NiciKreis/ET21-Frackstock/DOC_Frackstock/IMU.md

### IMU

Als IMU wurde bisher der BMI160 von Bosch verwendet. Dieser wurde abgekündigt, ein möglicher Ersatz ist der BMI323. Hardwaremässig kann der chip ersetzt werden, fraglich ist, ob die Arduino-Library mitspielt.

###
