NiciKreis/ET21-Frackstock/DOC_Frackstock/MCU.md

### Crystal

Der Clock wird mit zwei 14pF Kondensatoren gestützt. Gemäss Datenblatt RP2040 wäre dies jedoch nicht nötig. Falls der Quartz nicht schwingen sollte, müssten diese entfernt werden.

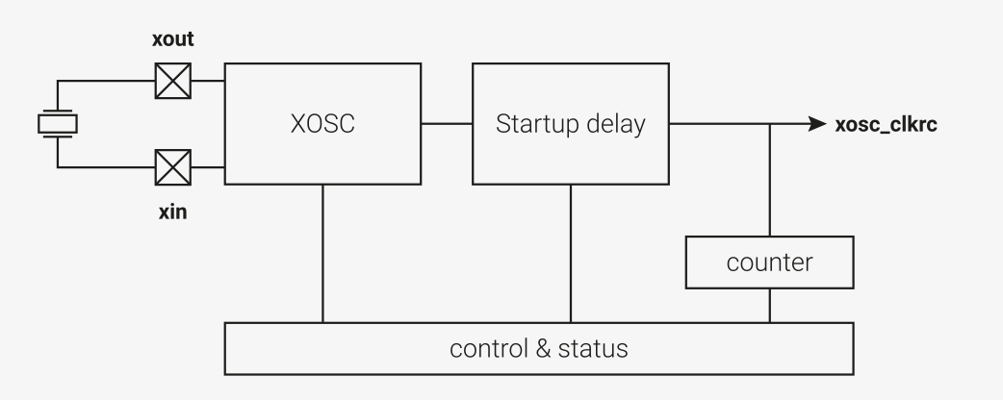
[picture p4: DOC_Frackstock/Assets/image-20240214121256330.png]
######
