NiciKreis/ET21-Frackstock/DOC_Frackstock/Assets/image-20231116143248241.png

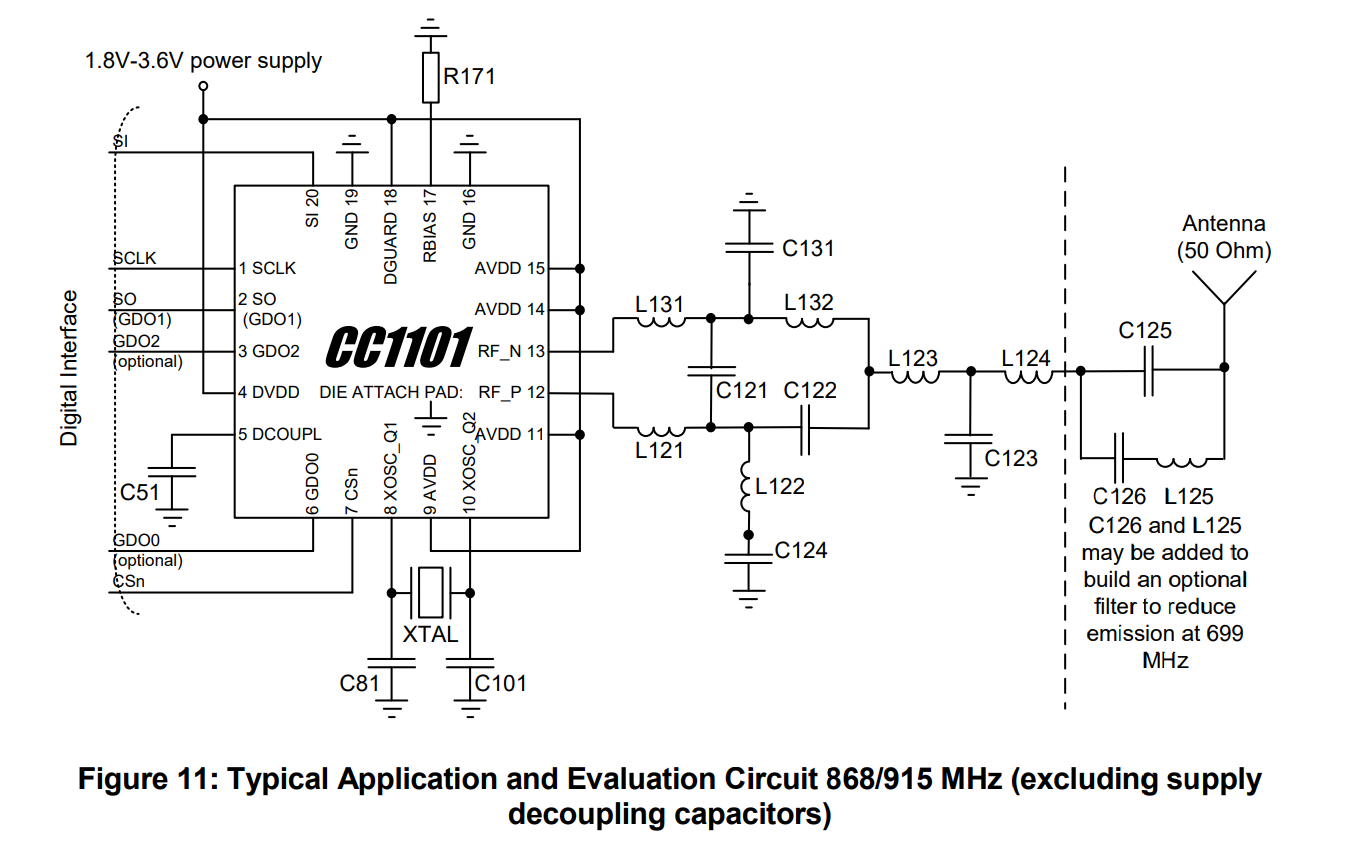
DOC_Frackstock/Assets/image-20231116143248241.png
