NiciKreis/ET21-Frackstock/DOC_Frackstock/Assets/image-20231116144048629.png

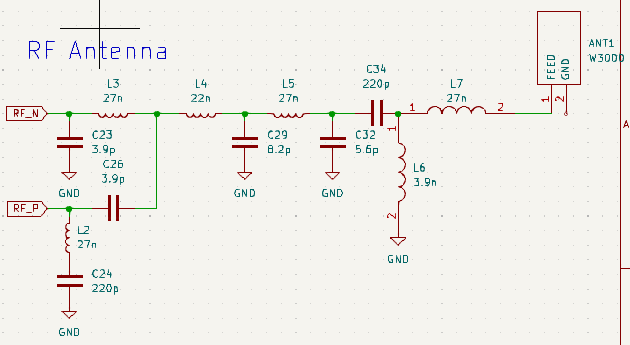
DOC_Frackstock/Assets/image-20231116144048629.png
