NiciKreis/ET21-Frackstock/IMG_20230823_181511.jpg

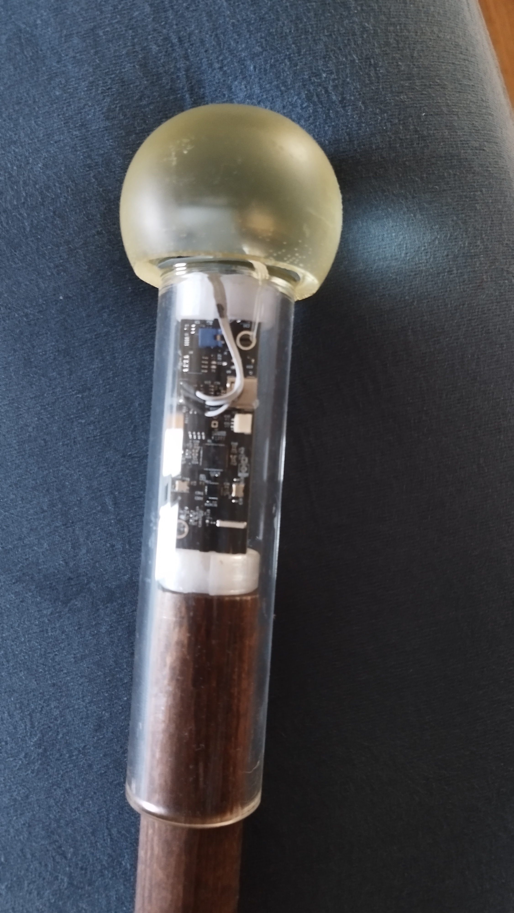
IMG_20230823_181511.jpg
