NiciKreis/ET21-Frackstock/IMG_20230823_181516.jpg

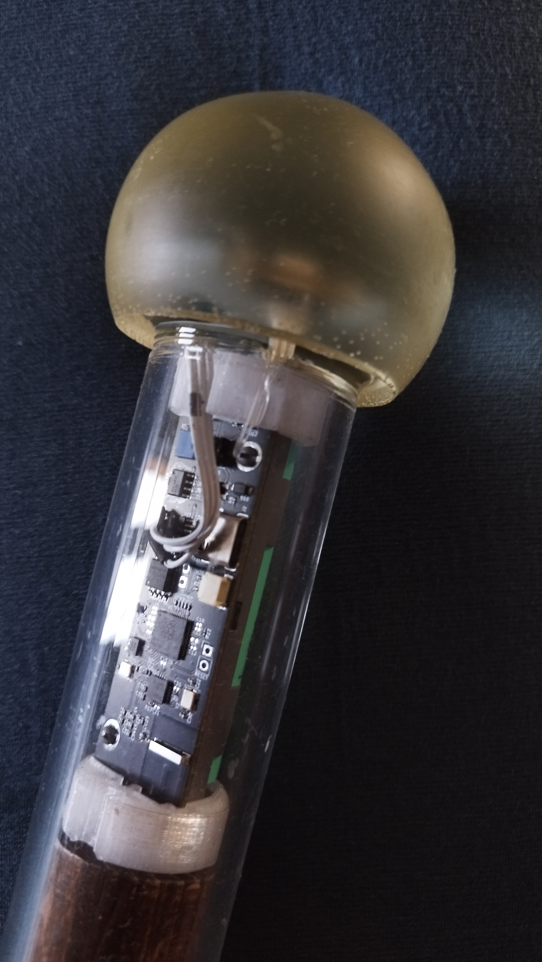
IMG_20230823_181516.jpg
