NiciKreis/ET21-Frackstock/IMG_20230823_181558.jpg

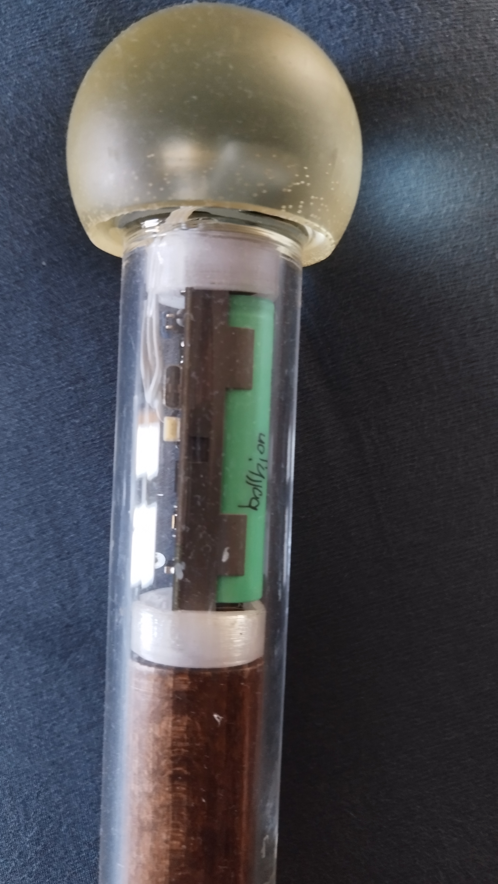
IMG_20230823_181558.jpg
