NiciKreis/ET21-Frackstock/IMG_20230823_181706.jpg

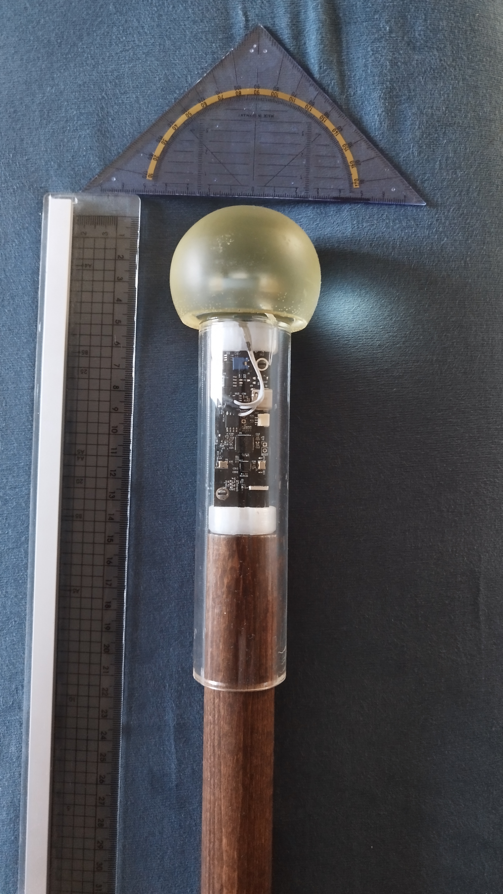
IMG_20230823_181706.jpg
