NiciKreis/ET21-Frackstock/IMG_20230823_181718.jpg

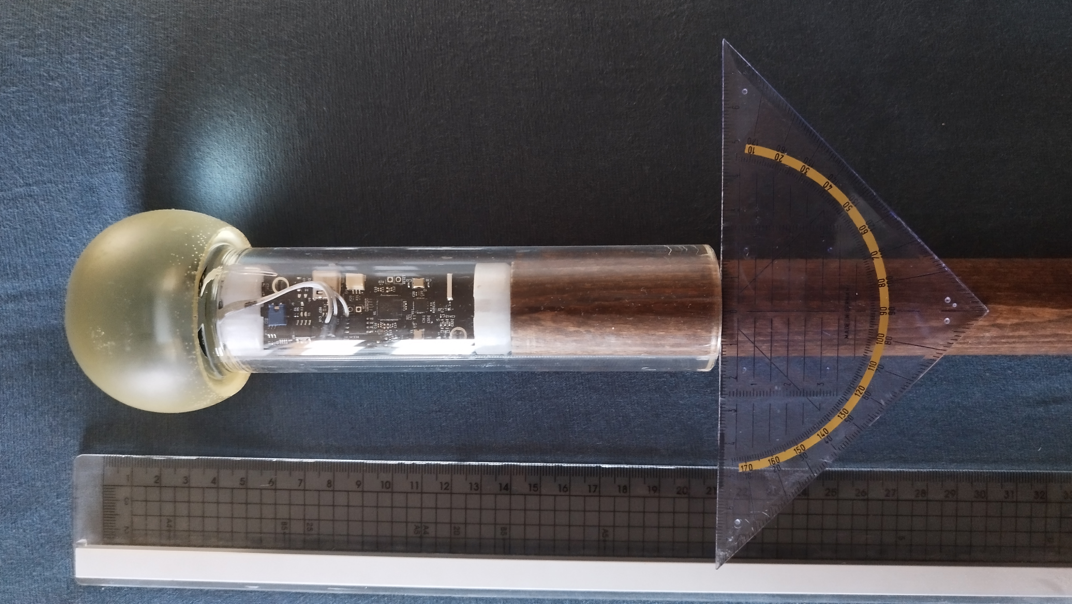
IMG_20230823_181718.jpg
