NiciKreis/ET21-Frackstock/PCB_Frackstock/Frackstock.step

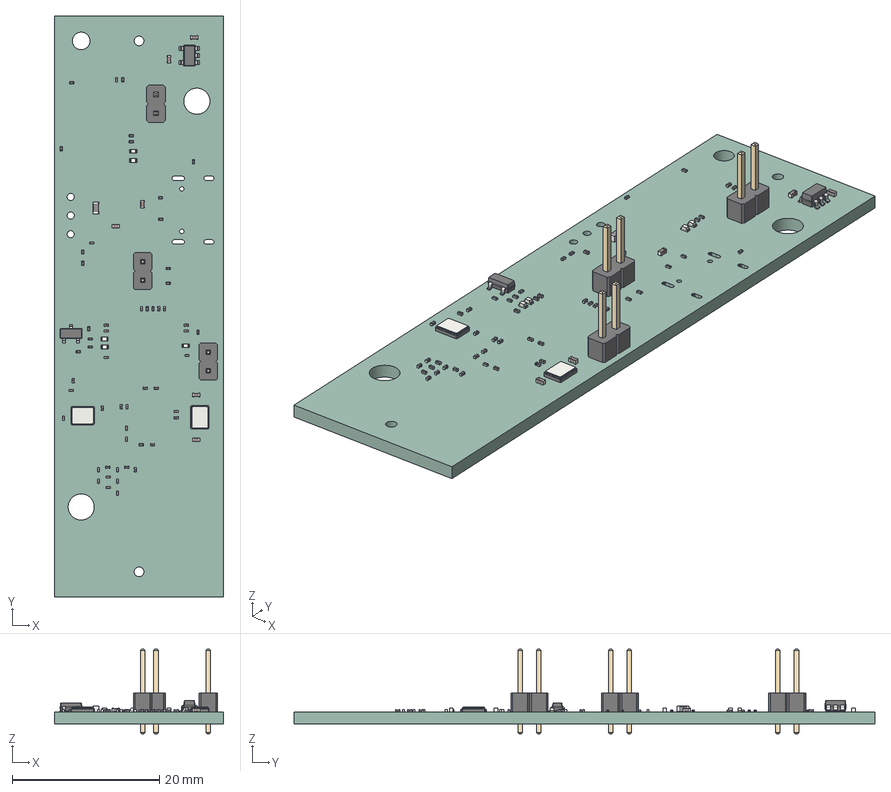
[picture p12: CAD file, 2023-11-22]
PCB_Frackstock/Frackstock.step
23.0 x 79.0 x 11.5 mm
Frackstock PCB
