NiciKreis/ET21-Frackstock/PCB_LedRing/Components/LIB_PCA9552D,118/PCA9552D,118.stp

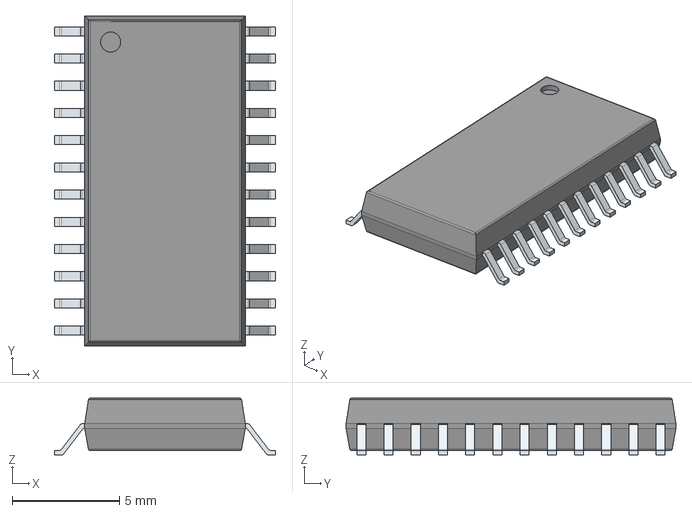
[picture p13: CAD file, 2024-02-25]
PCB_LedRing/Components/LIB_PCA9552D,118/PCA9552D,118.stp
10.3 x 15.4 x 2.65 mm
PinsArrayLR
