NiciKreis/ET21-Frackstock/PCB_LedRing/PCB_LedRing.step

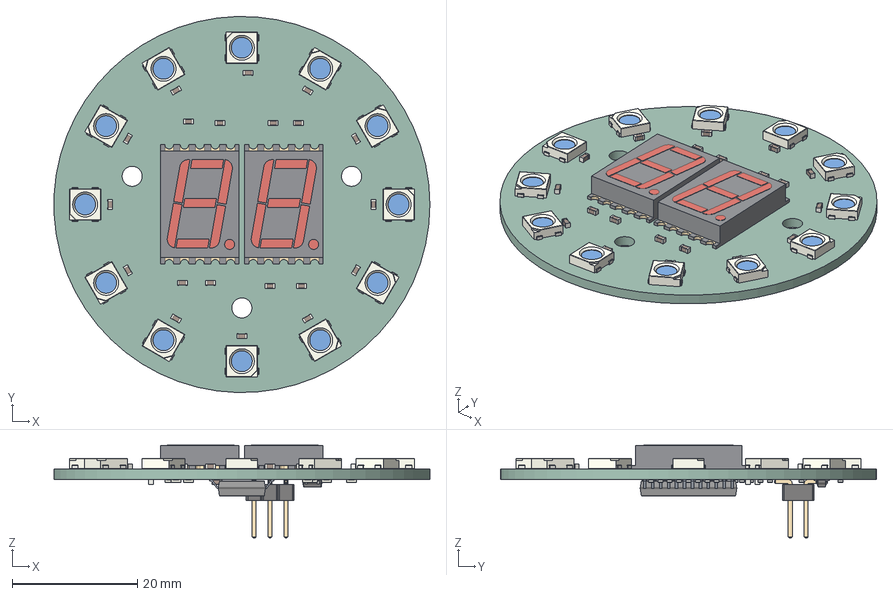
[picture p14: CAD file, 2024-04-09]
PCB_LedRing/PCB_LedRing.step
60.0 x 60.0 x 14.8 mm
LED_SK6812_PLCC4_50x50mm_P32mm x 12
C_0603_1608Metric x 23
7SEGMENT-LED__HDSM531_HDSM533_SMD x 2
SOT_23
R_0603_1608Metric x 27
ASSEMBLY
PinHeader_2x03_P254mm_Vertical_SMD
_autosave-PCB_LedRing PCB
