NiciKreis/ET21-Frackstock/PCB_LedRing/export/PCB_LedRing.pdf

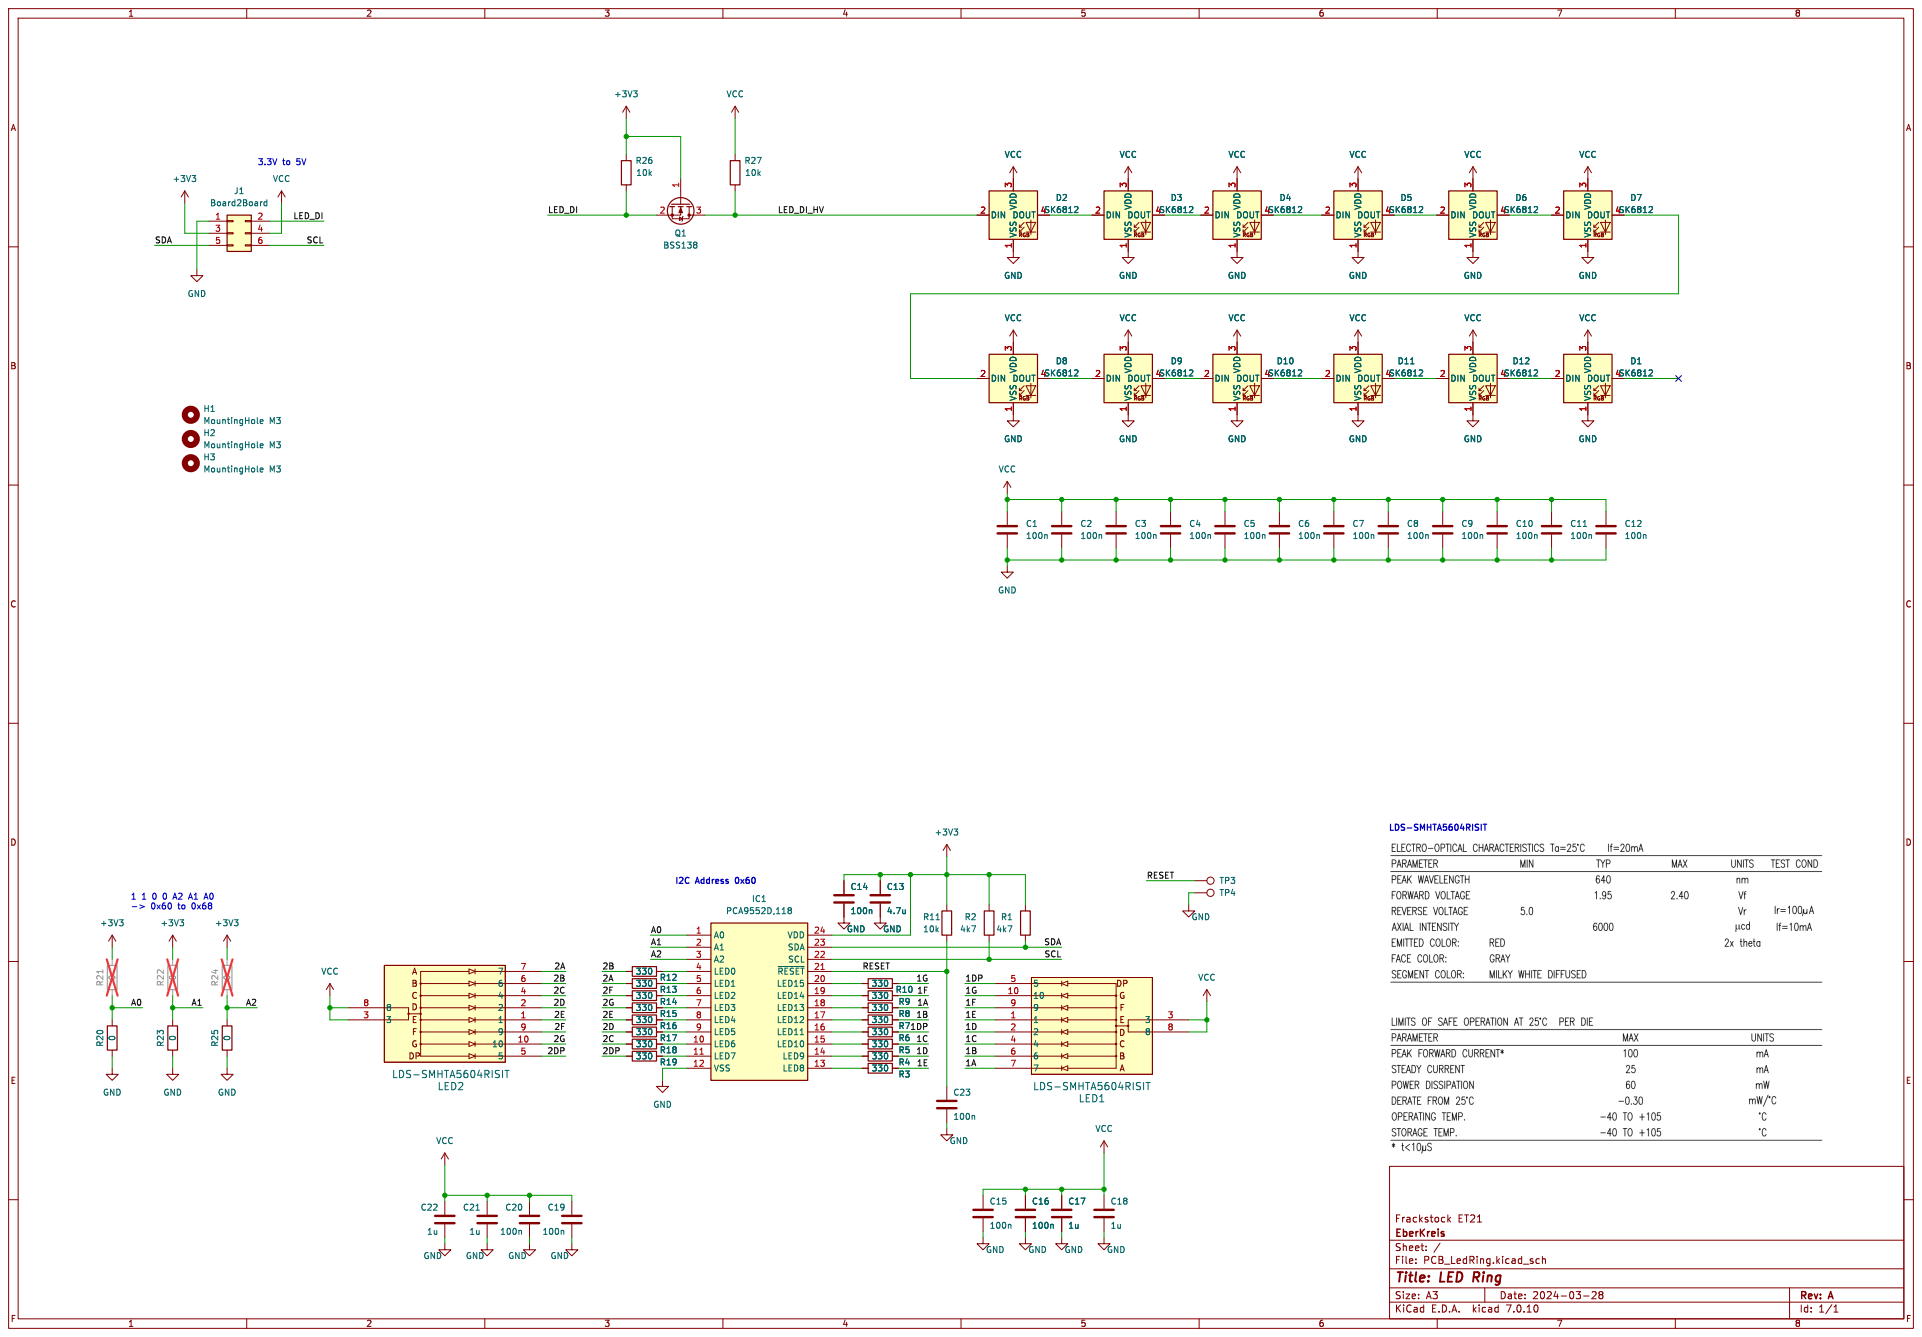
[picture p15: page 1]

3 DOUT 4 D5 SK6812 GND VSS RGB 1 DIN 2 VDD
D4 SK6812 VSS

3 DOUT 4 D10 SK6812 GND VSS RGB 1 DIN 2 VDD

3 DOUT 4 D11 SK6812 VSS RGB 1 DIN 2 VDD
D10 SK6812 VSS

LED15 20 ~{RESET}21 SCL 22 SDA 23 VDD 24 A2 3

Id: 1/1 Title: LED Ring
