NiciKreis/ET21-Frackstock/PCB_LedRing/PCB_LedRing.kicad_pcb

## KiCad design PCB_LedRing/PCB_LedRing.kicad_pcb (2024-04-05)

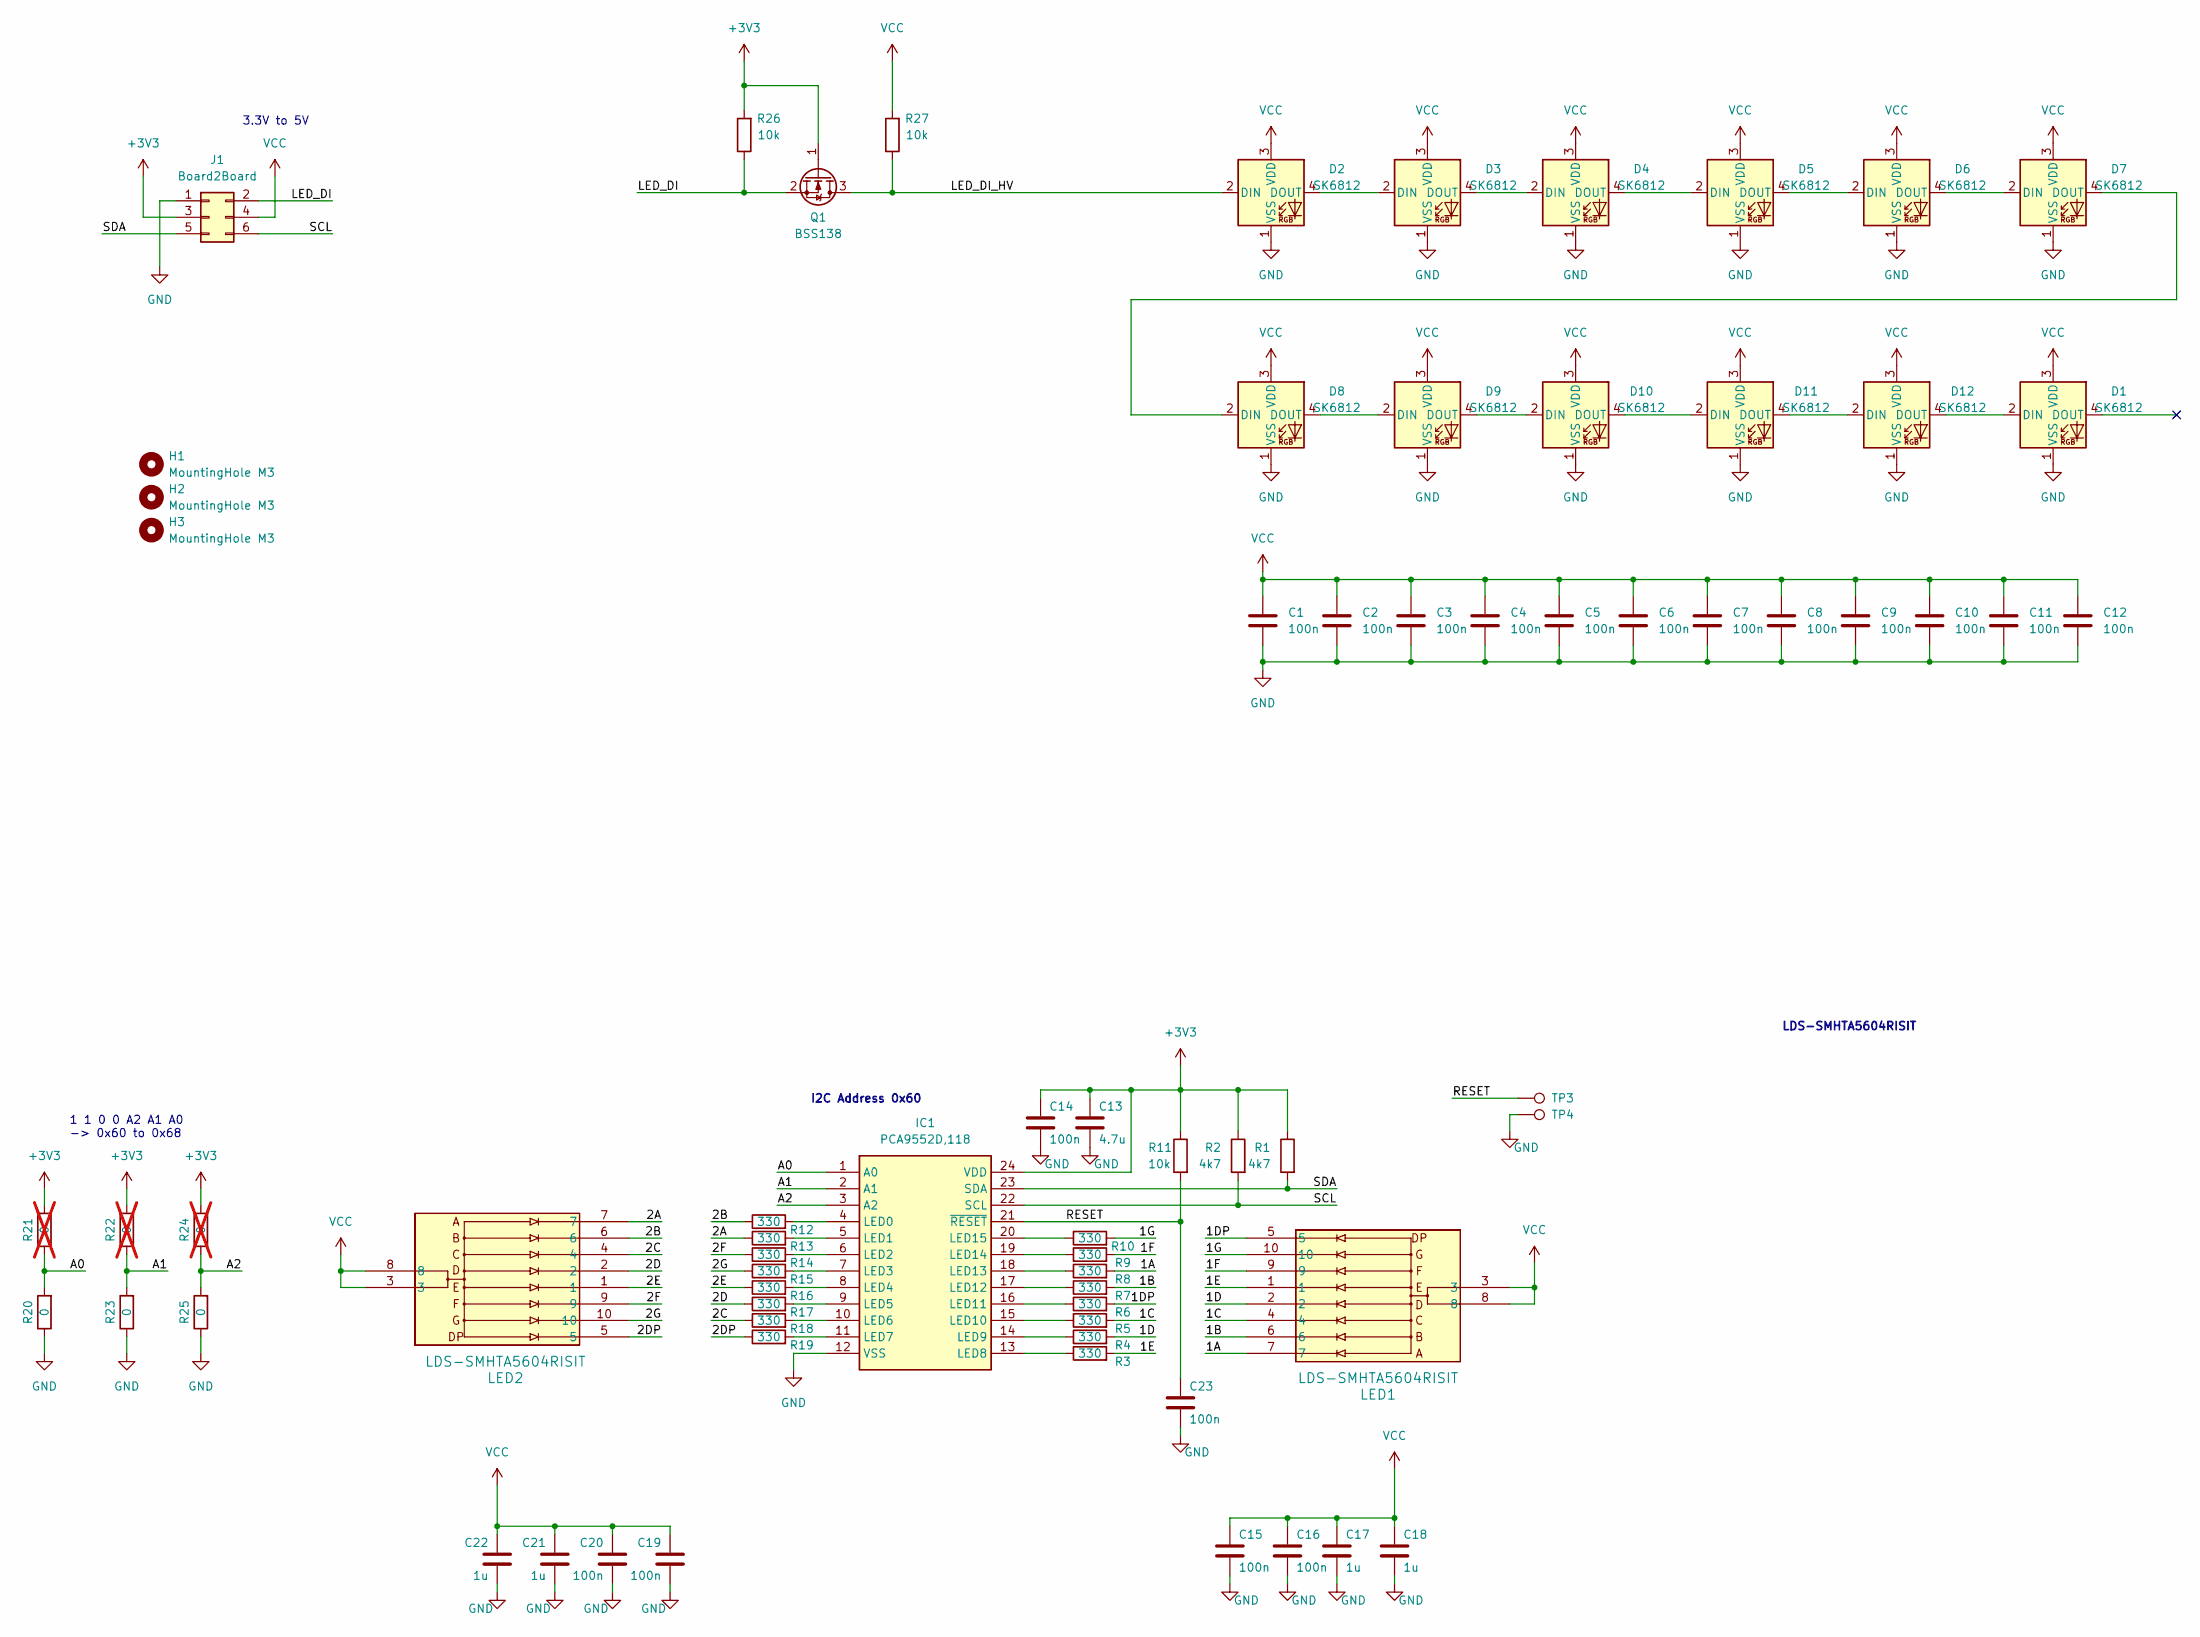
[picture p16: schematic PCB_LedRing.kicad_sch, LED Ring]

Parts:
C1, C2, C3, C4, C5, C6, C7, C8, C9, C10, C11, C12, C14, C15, C16, C19, C20, C23: 100n; C_0603_1608Metric_Pad1.08x0.95mm_HandSolder
C13: 4.7u; C_0603_1608Metric_Pad1.08x0.95mm_HandSolder
C17, C18, C21, C22: 1u; C_0603_1608Metric_Pad1.08x0.95mm_HandSolder
D1, D2, D3, D4, D5, D6, D7, D8, D9, D10, D11, D12: SK6812; LED_SK6812_PLCC4_5.0x5.0mm_P3.2mm
H1, H2, H3: MountingHole M3; MountingHole_3.2mm_M3
IC1: PCA9552D,118; SOIC127P1032X265-24N; Mouser Part Number 771-PCA9552D-T
J1: Board2Board; PinHeader_2x03_P2.54mm_Vertical_SMD; Mouser 649-1012938390602BLF
LED1, LED2: LDS-SMHTA5604RISIT; LDS-SMHTA5604RISIT_LUM; Mouser 696-LDSSMHTA5604RISI
Q1: BSS138; SOT-23; Mouser 512-BSS138
R1, R2: 4k7; R_0603_1608Metric_Pad0.98x0.95mm_HandSolder
R3, R4, R5, R6, R7, R8, R9, R10, R12, R13, R14, R15, R16, R17, R18, R19: 330; R_0603_1608Metric_Pad0.98x0.95mm_HandSolder
R11, R26, R27: 10k; R_0603_1608Metric_Pad0.98x0.95mm_HandSolder
R20, R23, R25: 0; R_0603_1608Metric_Pad0.98x0.95mm_HandSolder
R21, R22, R24: 0; R_0603_1608Metric_Pad0.98x0.95mm_HandSolder; not fitted
TP3, TP4: TestPoint; TestPoint_Pad_D3.0mm

Connections:
+3V3: C13.1, C14.1, IC1.24 (VDD), J1.3, Q1.1 (G), R1.1, R2.1, R11.1, R21.2, R22.2, R24.2, R26.2
/1A: LED1.7, R8.2
/1B: LED1.6, R7.2
/1C: LED1.4, R5.2
/1D: LED1.2, R4.2
/1DP: LED1.5, R6.2
/1E: LED1.1, R3.2
/1F: LED1.9, R9.2
/1G: LED1.10, R10.2
/2A: LED2.7, R13.1
/2B: LED2.6, R12.1
/2C: LED2.4, R18.1
/2D: LED2.2, R17.1
/2DP: LED2.5, R19.1
/2E: LED2.1, R16.1
/2F: LED2.9, R14.1
/2G: LED2.10, R15.1
/A0: IC1.1 (A0), R20.2, R21.1
/A1: IC1.2 (A1), R22.1, R23.2
/A2: IC1.3 (A2), R24.1, R25.2
/LED_DI: J1.2, Q1.2 (S), R26.1
/LED_DI_HV: D2.2 (DIN), Q1.3 (D), R27.1
/RESET: C23.1, IC1.21 (~RESET), R11.2, TP3.1
/SCL: IC1.22 (SCL), J1.6, R2.2
/SDA: IC1.23 (SDA), J1.5, R1.2
GND: C1.2, C2.2, C3.2, C4.2, C5.2, C6.2, C7.2, C8.2, C9.2, C10.2, C11.2, C12.2, C13.2, C14.2, C15.2, C16.2, C17.2, C18.2, C19.2, C20.2, C21.2, C22.2, C23.2, D1.1 (VSS), D2.1 (VSS), D3.1 (VSS), D4.1 (VSS), D5.1 (VSS), D6.1 (VSS), D7.1 (VSS), D8.1 (VSS), D9.1 (VSS), D10.1 (VSS), D11.1 (VSS), D12.1 (VSS), IC1.12 (VSS), J1.1, R20.1, R23.1, R25.1, TP4.1
unnamed: D1.2 (DIN), D12.4 (DOUT)
unnamed: D2.4 (DOUT), D3.2 (DIN)
unnamed: D3.4 (DOUT), D4.2 (DIN)
unnamed: D4.4 (DOUT), D5.2 (DIN)
unnamed: D5.4 (DOUT), D6.2 (DIN)
unnamed: D6.4 (DOUT), D7.2 (DIN)
unnamed: D7.4 (DOUT), D8.2 (DIN)
unnamed: D8.4 (DOUT), D9.2 (DIN)
unnamed: D9.4 (DOUT), D10.2 (DIN)
unnamed: D10.4 (DOUT), D11.2 (DIN)
unnamed: D11.4 (DOUT), D12.2 (DIN)
unnamed: IC1.4 (LED0), R12.2
unnamed: IC1.5 (LED1), R13.2
unnamed: IC1.6 (LED2), R14.2
unnamed: IC1.7 (LED3), R15.2
unnamed: IC1.8 (LED4), R16.2
unnamed: IC1.9 (LED5), R17.2
unnamed: IC1.10 (LED6), R18.2
unnamed: IC1.11 (LED7), R19.2
unnamed: IC1.13 (LED8), R3.1
unnamed: IC1.14 (LED9), R4.1
unnamed: IC1.15 (LED10), R5.1
unnamed: IC1.16 (LED11), R6.1
unnamed: IC1.17 (LED12), R7.1
unnamed: IC1.18 (LED13), R8.1
unnamed: IC1.19 (LED14), R9.1
unnamed: IC1.20 (LED15), R10.1
VCC: C1.1, C2.1, C3.1, C4.1, C5.1, C6.1, C7.1, C8.1, C9.1, C10.1, C11.1, C12.1, C15.1, C16.1, C17.1, C18.1, C19.1, C20.1, C21.1, C22.1, D1.3 (VDD), D2.3 (VDD), D3.3 (VDD), D4.3 (VDD), D5.3 (VDD), D6.3 (VDD), D7.3 (VDD), D8.3 (VDD), D9.3 (VDD), D10.3 (VDD), D11.3 (VDD), D12.3 (VDD), J1.4, LED1.3, LED1.8, LED2.3, LED2.8, R27.2

Notes on the sheet:
1 1 0 0 A2 A1 A0 -> 0x60 to 0x68
I2C Address 0x60
3.3V to 5V
LDS-SMHTA5604RISIT

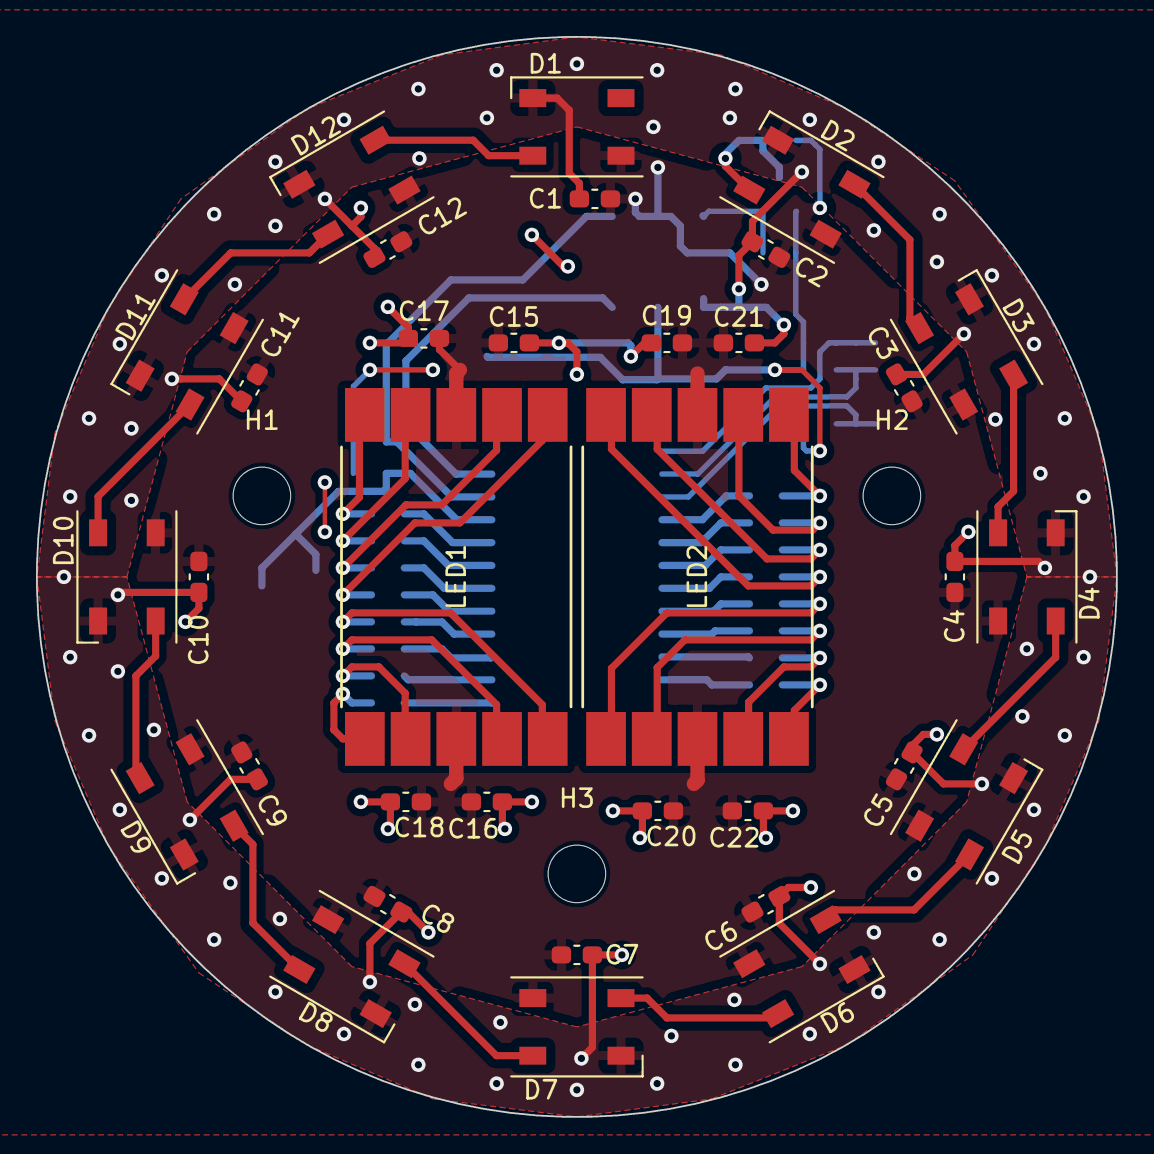
[picture p17: board PCB_LedRing.kicad_pcb from above]

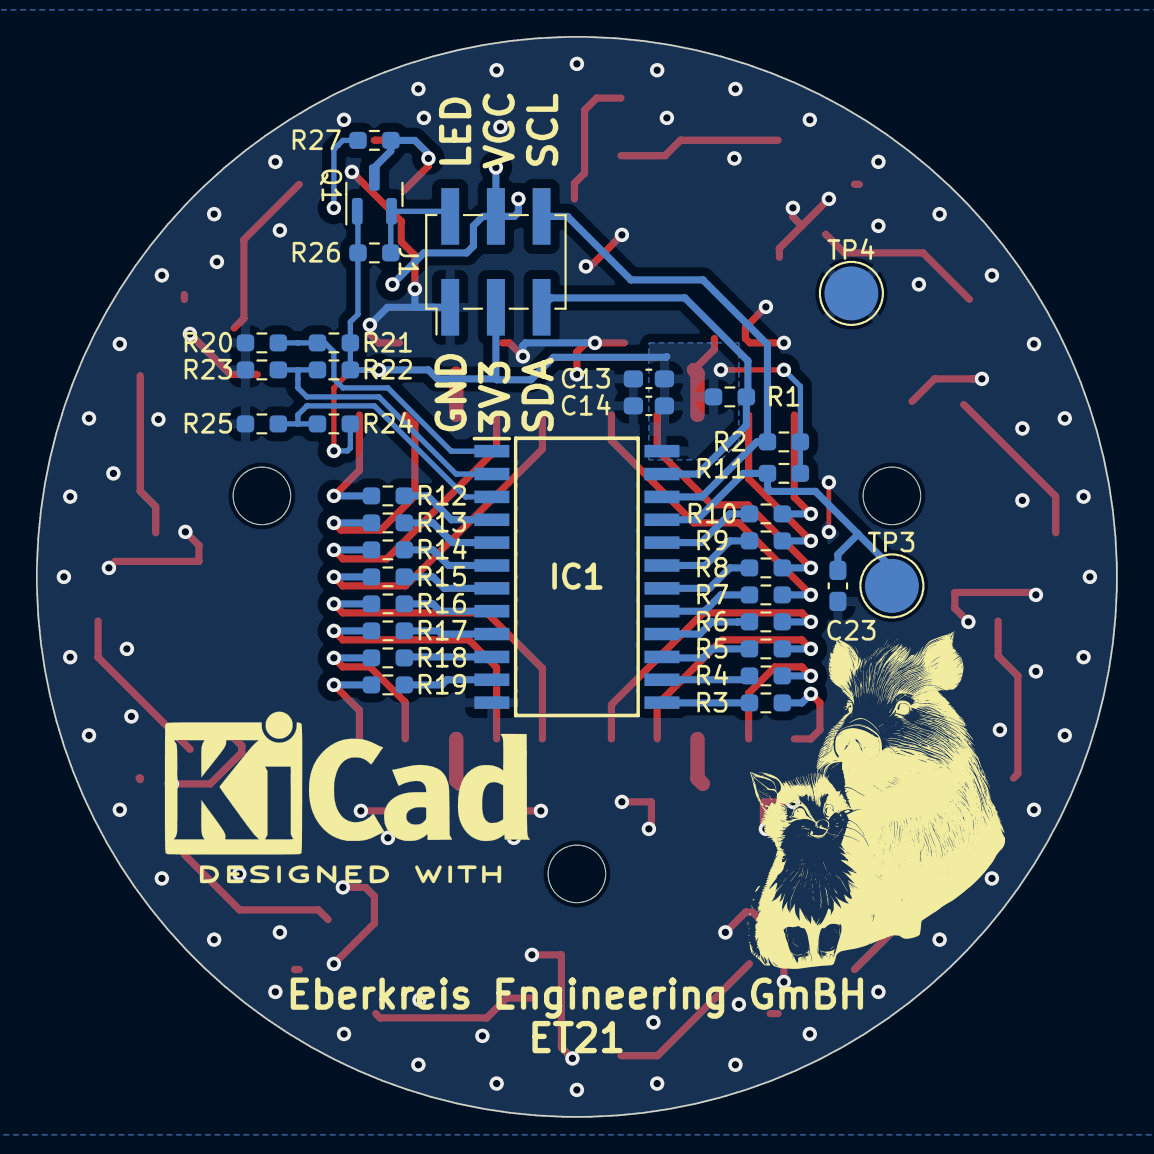
[picture p18: board PCB_LedRing.kicad_pcb from below]

Board: 2 copper layers, 60.0 x 60.0 mm, 72 parts (35 on the bottom side), 54 nets.
