NiciKreis/ET21-Frackstock/PCB_Frackstock/Frackstock.kicad_pcb

## KiCad design PCB_Frackstock/Frackstock.kicad_pcb (2024-03-28)

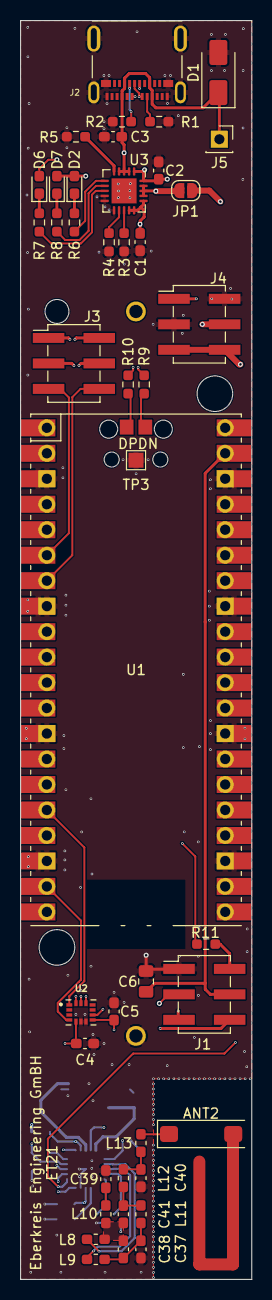
[picture p19: board Frackstock.kicad_pcb from above]

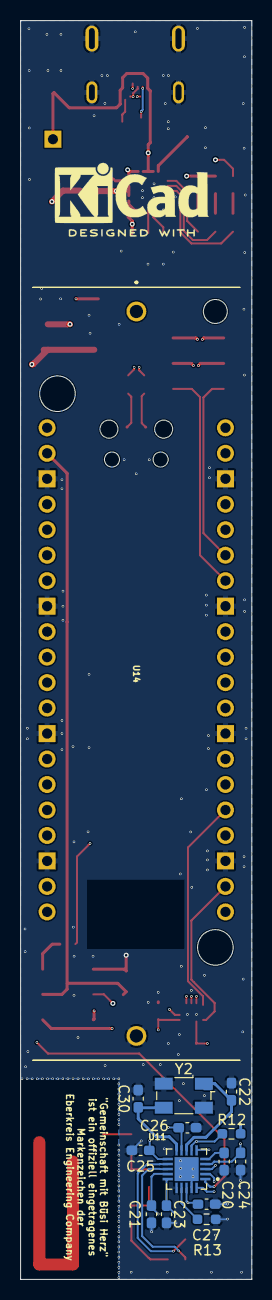
[picture p20: board Frackstock.kicad_pcb from below]

Board: 4 copper layers, 23.0 x 125.5 mm, 59 parts (14 on the bottom side), 56 nets.

Parts:
ANT2: W3000
C1, C2: 4.7u; C_0603_1608Metric_Pad1.08x0.95mm_HandSolder
C3: 10u; C_0603_1608Metric_Pad1.08x0.95mm_HandSolder
C4, C5, C20, C21, C23, C24, C25, C26, C27: 100n; C_0603_1608Metric_Pad1.08x0.95mm_HandSolder
C6: 330u; C_0805_2012Metric_Pad1.18x1.45mm_HandSolder
C22, C30: 20p; C_0603_1608Metric_Pad1.08x0.95mm_HandSolder
C37, C41: 1.5pF; C_0603_1608Metric_Pad1.08x0.95mm_HandSolder
C38: 1p; C_0603_1608Metric_Pad1.08x0.95mm_HandSolder
C39: 100pF; C_0603_1608Metric_Pad1.08x0.95mm_HandSolder
C40: 3.3pF; C_0603_1608Metric_Pad1.08x0.95mm_HandSolder
D1: SMAJ5.0A; D_SMA
D2: Blau; LED_0603_1608Metric_Pad1.05x0.95mm_HandSolder
D6: Rot; LED_0603_1608Metric_Pad1.05x0.95mm_HandSolder
D7: Grün; LED_0603_1608Metric_Pad1.05x0.95mm_HandSolder
J1, J3, J4: Conn_02x03_Pin; PinHeader_2x03_P2.54mm_Vertical_SMD_kleiner
J2: 105450-0101; MOLEX_105450-0101
J5: VBUS; PinSocket_1x01_P2.54mm_Vertical
JP1: SolderJumper_2_Open; SolderJumper-2_P1.3mm_Open_RoundedPad1.0x1.5mm
L8, L9, L12, L13: 12nH; L_0603_1608Metric_Pad1.05x0.95mm_HandSolder
L10, L11: 18nH; L_0603_1608Metric_Pad1.05x0.95mm_HandSolder
R1, R2: 5.1k; R_0603_1608Metric_Pad0.98x0.95mm_HandSolder
R3: 2k; R_0603_1608Metric_Pad0.98x0.95mm_HandSolder
R4: 8.2k; R_0603_1608Metric_Pad0.98x0.95mm_HandSolder
R5, R12: 10k; R_0603_1608Metric_Pad0.98x0.95mm_HandSolder
R6, R8: 390; R_0603_1608Metric_Pad0.98x0.95mm_HandSolder
R7: 430; R_0603_1608Metric_Pad0.98x0.95mm_HandSolder
R9, R10: 27; R_0603_1608Metric_Pad0.98x0.95mm_HandSolder
R11: 470; R_0603_1608Metric_Pad0.98x0.95mm_HandSolder
R13: 56k; R_0603_1608Metric_Pad0.98x0.95mm_HandSolder
TP1, TP2: TestPoint_Alt; TestPoint_Pad_1.5x1.5mm_small
TP3: TestPoint_Alt; TestPoint_Pad_1.5x1.5mm
U1: Pico; RPi_Pico_SMD_ohne_Debug
U2: BMI160; PQFN50P250X300X88-14N
U3: MCP73871-2CC; QFN-20-1EP_4x4mm_P0.5mm_EP2.5x2.5mm
U11: CC1101RGPR; QFN50P400X400X100-21N
U14: 1043; Keystone_1043
Y2: 26MHz; Crystal_SMD_Abracon_ABM3B-4Pin_5.0x3.2mm

Connections:
+3.3V: C4.1, C5.1, C21.1, C23.1, C24.1, C25.1, C26.1, C27.1, J1.3, J4.4, R12.1, U1.36 (3V3), U2.5 (VDDIO), U2.8 (VDD), U11.4 (DVDD), U11.9 (AVDD_9), U11.11 (AVDD_11), U11.14 (AVDD_14), U11.15 (AVDD_15), U11.18 (DGUARD)
BAT_O: C2.1, C6.2, D6.2 (A), J1.4, J4.5, J4.6, U1.39 (VSYS), U3.1 (OUT), U3.20 (OUT)
BAT_P: C1.1, U3.14 (V_{BAT}), U3.15 (V_{BAT}), U3.16 (V_{BAT_SENSE}), U14.1 (+)
COM_CLK: U1.24 (GPIO18), U11.1 (SCLK)
COM_CS: R12.2, U1.22 (GPIO17), U11.7 (CSN)
COM_DO1: U1.26 (GPIO20), U11.6 (GDO(ATEST))
COM_DO2: U1.27 (GPIO21), U11.3 (GDO2)
COM_MISO: U1.21 (GPIO16), U11.2 (SO(GDO1))
COM_MOSI: U1.25 (GPIO19), U11.20 (SI)
DN: J2.A7 (D1-), J2.B7 (D2-), R9.2
DP: J2.A6 (D1+), J2.B6 (D2+), R10.2
GND: ANT2.2 (GND), C1.2, C2.2, C3.2, C4.2, C5.2, C6.1, C20.2, C21.2, C22.2, C23.2, C24.2, C25.2, C26.2, C27.2, C30.2, C37.1, C39.1, C40.1, D1.2 (A), J1.1, J2.A1 (GND1), J2.A12 (GND2), J2.B1 (GND3), J2.B12 (GND4), J2.S1 (SHIELD), J2.S2 (SHIELD__1), J2.S3 (SHIELD__2), J2.S4 (SHIELD__3), J4.2, J4.3, R1.1, R2.1, R3.1, R4.1, R5.1, R13.2, TP3.1, U1.3 (GND), U1.8 (GND), U1.13 (GND), U1.18 (GND), U1.23 (GND), U1.28 (GND), U1.33 (AGND), U1.38 (GND), U2.6 (GNDIO), U2.7 (GND), U3.9 (~TE), U3.10 (V_{SS}), U3.11 (V_{SS}), U3.21 (V_{SS}), U11.16 (GND_16), U11.19 (GND_19), U11.21 (EXP), U14.2 (-), Y2.2, Y2.4
GPIO2: J3.3, U1.4 (GPIO2)
GPIO3: J3.4, U1.5 (GPIO3)
GPIO4: J3.5, U1.6 (GPIO4)
GPIO5: J3.6, U1.7 (GPIO5)
LED_EXT: R11.1, U1.12 (GPIO9)
unnamed: ANT2.1 (FEED), L13.2
unnamed: C37.2, C38.2, L9.2, L11.1
unnamed: C38.1, C41.2, L8.2, L10.1
unnamed: C39.2, L10.2
unnamed: C40.2, L12.2, L13.1
unnamed: C41.1, L11.2, L12.1
unnamed: D2.1 (K), R6.1
unnamed: D6.1 (K), R7.1
unnamed: D7.1 (K), R8.1
unnamed: J1.2, R11.2
unnamed: J2.A5 (CC1), R1.2
unnamed: J2.B5 (CC2), R2.2
unnamed: JP1.1 (A), U1.40 (VBUS)
unnamed: R9.1, TP1.1
unnamed: R10.1, TP2.1
unnamed: R3.2, U3.13 (PROG1)
unnamed: R4.2, U3.12 (PROG3)
unnamed: R7.2, U3.8 (STAT1/~LBO)
unnamed: R8.2, U3.7 (STAT2)
unnamed: R5.2, U3.5 (THERM)
unnamed: R6.2, U3.6 (~PG)
unnamed: C20.1, U11.5 (DCOUPL)
unnamed: R13.1, U11.17 (RBIAS)
RESET: J4.1, U1.30 (RUN)
RF_N: L9.1, U11.13 (RF_N)
RF_P: L8.1, U11.12 (RF_P)
SCL_EXT: J1.6, U1.32 (GPIO27_ADC1)
SDA_EXT: J1.5, U1.31 (GPIO26_ADC0)
SEN_CS: U1.17 (GPIO13), U2.12 (CSB)
SEN_INT1: U1.19 (GPIO14), U2.4 (INT1)
SEN_INT2: U1.20 (GPIO15), U2.9 (INT2)
SEN_MISO: U1.16 (GPIO12), U2.1 (SDO)
SEN_MOSI: U1.15 (GPIO11), U2.14 (SDX)
SEN_SCK: U1.14 (GPIO10), U2.13 (SCX)
UART0_RX: J3.2, U1.2 (GPIO1)
UART0_TX: J3.1, U1.1 (GPIO0)
VBUS: C3.1, D1.1 (K), D2.2 (A), D7.2 (A), J2.A4 (VBUS1), J2.A9 (VBUS2), J2.B4 (VBUS3), J2.B9 (VBUS4), J5.1, JP1.2 (B), U3.2 (VPCC), U3.3 (SEL), U3.4 (PROG2), U3.17 (CE), U3.18 (IN), U3.19 (IN)
XOSC_Q1: C22.1, U11.8 (XOSC_Q1), Y2.1
XOSC_Q2: C30.1, U11.10 (XOSC_Q2), Y2.3
