NiciKreis/ET21-Frackstock/SW_Frackstock/src/RGB_LUT.h

const uint8_t LUT[300][3]={{5,0,0},
{10,0,0},
{15,0,0},
{20,0,0},
{26,0,0},
{31,0,0},
{36,0,0},
{41,0,0},
{46,0,0},
{51,0,0},
{56,0,0},
{61,0,0},
{66,0,0},
{71,0,0},
{77,0,0},
{82,0,0},
{87,0,0},
{92,0,0},
{97,0,0},
{102,0,0},
{107,0,0},
{112,0,0},
{117,0,0},
{122,0,0},
{128,0,0},
{133,0,0},
{138,0,0},
{143,0,0},
{148,0,0},
{153,0,0},
{158,0,0},
{163,0,0},
{168,0,0},
{173,0,0},
{179,0,0},
{184,0,0},
{189,0,0},
{194,0,0},
{199,0,0},
{204,0,0},
{209,0,0},
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

const uint8_t STROBO[300]={1,1,1,1,1,1,0,0,0,0,0,0,1,1,1,1,1,1,0,0,0,0,0,0,1,1,1,1,1,1,0,0,0,0,0,0,1,1,1,1,1,1,0,0,0,0,0,0,1,1,1,1,1,1,0,0,0,0,0,0,
                           1,1,1,1,1,1,0,0,0,0,0,0,1,1,1,1,1,1,0,0,0,0,0,0,1,1,1,1,1,1,0,0,0,0,0,0,1,1,1,1,1,1,0,0,0,0,0,0,1,1,1,1,1,1,0,0,0,0,0,0,
                           1,1,1,1,1,1,0,0,0,0,0,0,1,1,1,1,1,1,0,0,0,0,0,0,1,1,1,1,1,1,0,0,0,0,0,0,1,1,1,1,1,1,0,0,0,0,0,0,1,1,1,1,1,1,0,0,0,0,0,0,
                           1,1,1,1,1,1,0,0,0,0,0,0,1,1,1,1,1,1,0,0,0,0,0,0,1,1,1,1,1,1,0,0,0,0,0,0,1,1,1,1,1,1,0,0,0,0,0,0,1,1,1,1,1,1,0,0,0,0,0,0,
                           1,1,1,1,1,1,0,0,0,0,0,0,1,1,1,1,1,1,0,0,0,0,0,0,1,1,1,1,1,1,0,0,0,0,0,0,1,1,1,1,1,1,0,0,0,0,0,0,1,1,1,1,1,1,0,0,0,0,0,0};


const uint8_t RGB[15][3]={
    {255,255,255},
    {255,0,0},
    {0,255,0},
    {0,0,255},
    {255,255,0},
    {0,255,255},
    {255,0,255},
    {255,140,0},
    {127,255,0},
    {0,255,127},
    {64,224,208},
    {0,191,255},
    {138,43,226},
    {128,0,128},
    {255,105,180}
};

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
    0x80,0x7b,0x77,0x74,0x70,0x6c,0x68,0x64,0x60,0x5c,0x58,0x54,0x51,0x4d,0x49,0x46,0x42,0x3f,0x3b,0x38,
    0x35,0x31,0x2e,0x2b,0x28,0x25,0x23,0x20,0x1d,0x1b,0x18,0x16,0x14,0x12,0x10,0xe,0xc,0xa,0x9,0x8,
    0x6,0x5,0x4,0x3,0x2,0x2,0x1,0x1
};
