NiciKreis/ET21-Frackstock/(commit log)

2023-11-22 Start Project
    [BOM.csv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]
2023-11-24 Battery Management and change parts to 0603
    [InputOutput.kicad_sch, MCUrp2040.kicad_sch, PowerSupply.kicad_sch]
2024-02-14 Schema fertig
    [Frackstock.kicad_pcb, InputOutput.kicad_sch, MCUrp2040.kicad_sch, PowerSupply.kicad_sch]
2024-02-25 Add LED Ring Board
    [PCA9552D,118.stp, PCB_LedRing.kicad_pcb, PCB_LedRing.kicad_sch]
2024-02-25 Wire Digits and LEDs
    [PCB_LedRing.kicad_pcb, PCB_LedRing.kicad_sch]
2024-02-27 LED Board DRC
    [PCB_LedRing.kicad_pcb, PCB_LedRing.kicad_sch]
2024-03-10 Layout Fertig
    [Frackstock.kicad_pcb, InputOutput.kicad_sch, MCUrp2040.kicad_sch]
2024-03-12 Change connector
    [PCB_LedRing.kicad_pcb, PCB_LedRing.kicad_sch]
2024-03-13 Layout Update
    [InputOutput.kicad_sch, MCUrp2040.kicad_sch, PowerSupply.kicad_sch]
2024-03-13 USB Differenziell
    [Frackstock.kicad_pcb, InputOutput.kicad_sch]
2024-03-21 Update LED ring based on review
    [PCB_LedRing.kicad_pcb, PCB_LedRing.kicad_sch]
2024-03-28 Add Level Shifter
    [PCB_LedRing.kicad_pcb, PCB_LedRing.kicad_sch]
2024-03-28 Fracstock PCB final commit
    DRC check, PCB review done, ready to order
    [Frackstock.kicad_pcb, Frackstock.kicad_sch, InputOutput.kicad_sch, MCUrp2040.kicad_sch, PowerSupply.kicad_sch]
2024-03-28 Frackstock Gerber added
    [Frackstock-B_Cu.gbl, Frackstock-B_Mask.gbs, Frackstock-B_Paste.gbp, Frackstock-B_Silkscreen.gbo, Frackstock-Edge_Cuts.gm1, Frackstock-F_Cu.gtl, Frackstock-F_Mask.gts, Frackstock-F_Paste.gtp]
2024-03-28 LED Ring Gerber export
    [PCB_LedRing.kicad_pcb]
2024-04-03 Add Mouser numbers
    [PCB_LedRing.kicad_pcb, PCB_LedRing.kicad_sch]
2024-04-05 Bauteiländerungen
    [MCUrp2040.kicad_sch]
